jeremy123322/Self-playing-piano/1_Documentation/images/IMG_1840.jpg

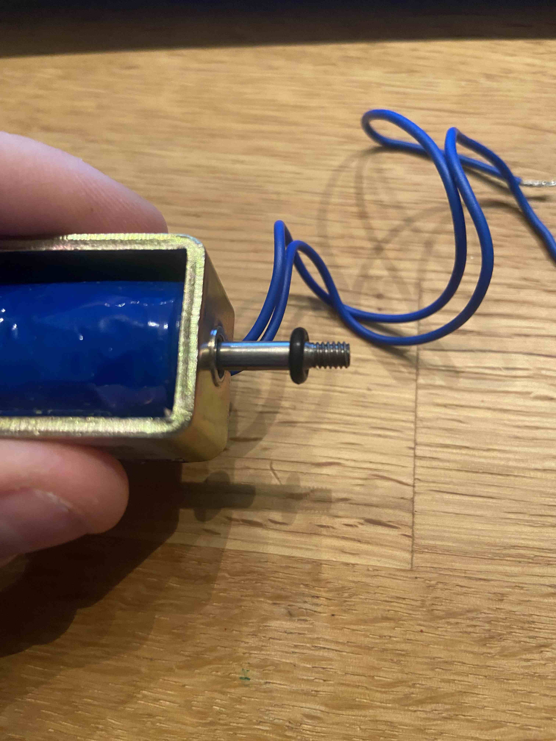
1_Documentation/images/IMG_1840.jpg
