jeremy123322/Self-playing-piano/4_Datasheets/PWM_Expander.png

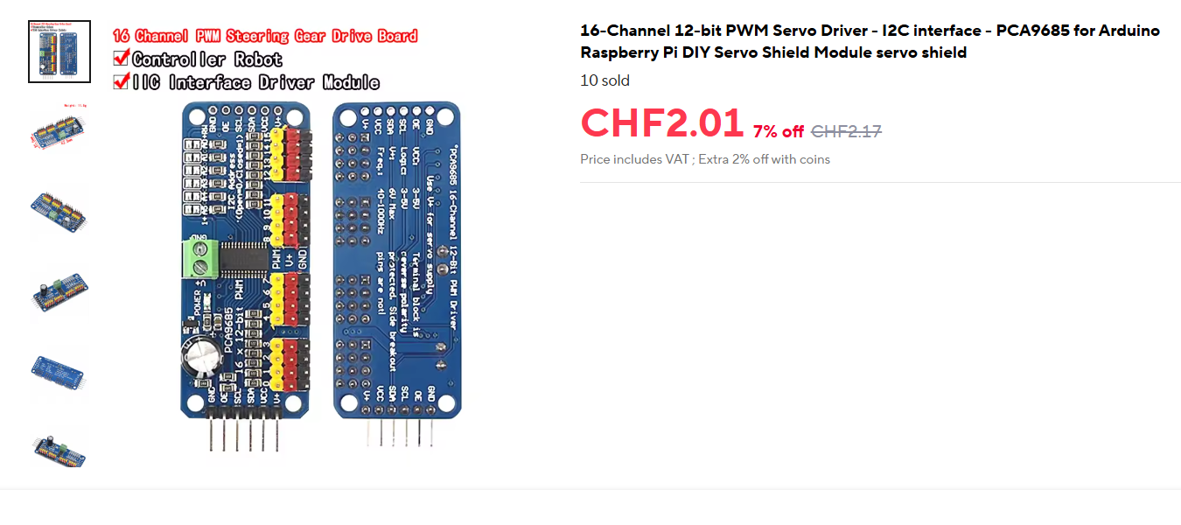
4_Datasheets/PWM_Expander.png
