jeremy123322/Self-playing-piano/5_Images/IMG_1639.jpg

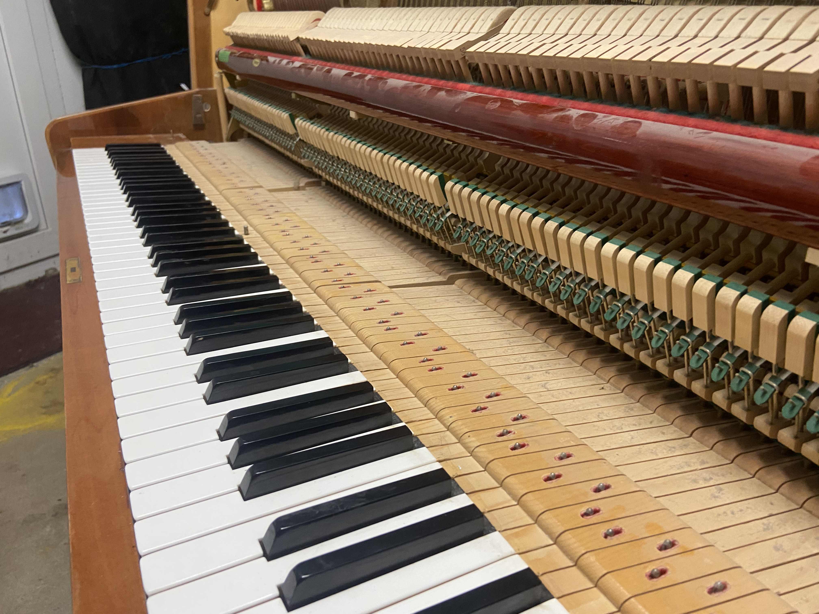
5_Images/IMG_1639.jpg
