jeremy123322/Self-playing-piano/5_Images/IMG_1664.jpg

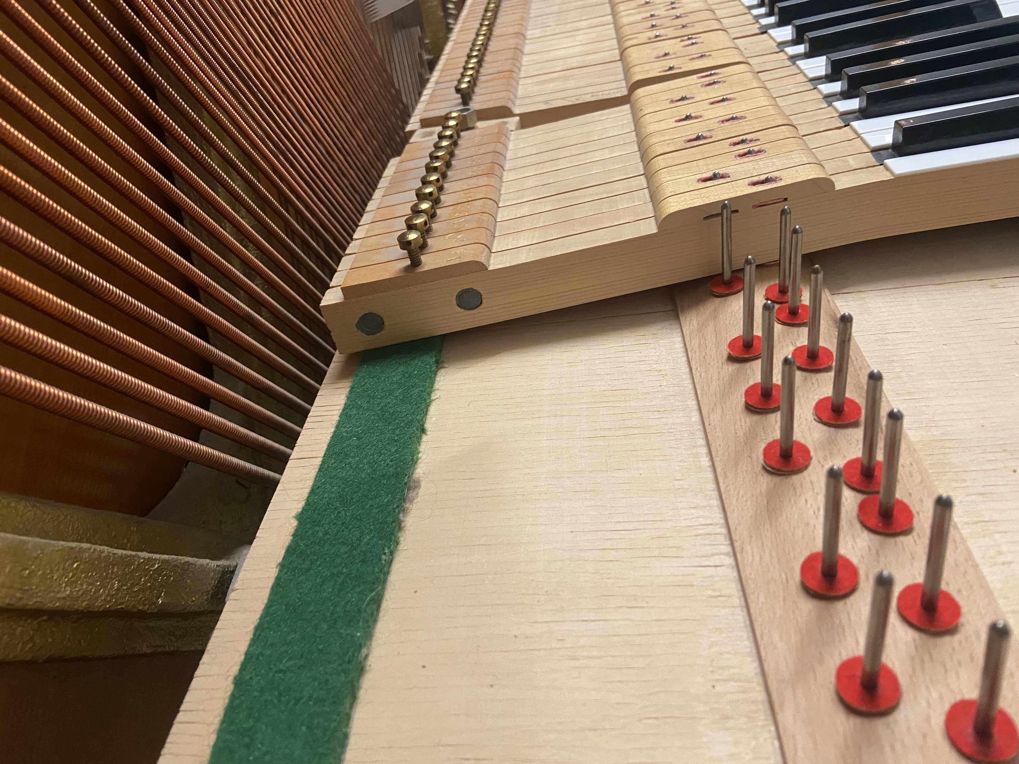
5_Images/IMG_1664.jpg
