jeremy123322/Self-playing-piano/5_Images/IMG_1673.jpg

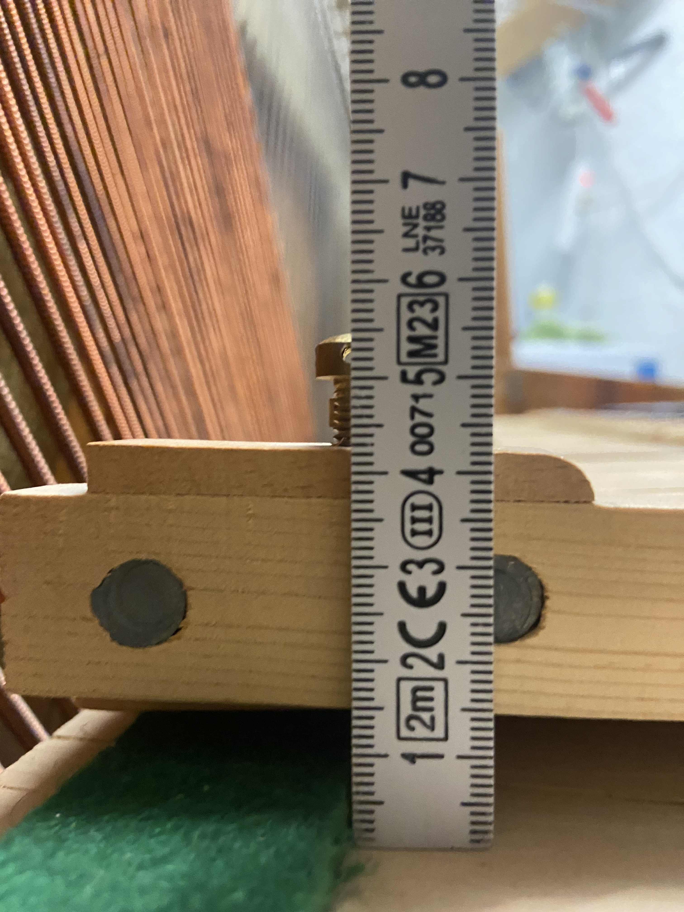
5_Images/IMG_1673.jpg
