jeremy123322/Self-playing-piano/2_Fabrication/BOM.xlsx

Liste de pièces self-playing-piano
Nom | Description | Fournisseur | Fabricant | Prix/Pce | Qté | Prix
Piano |  |  |  | 0 | 1 | 0
Tuning Hammer |  |  |  | CHF 28.60 | 1 | CHF 28.60
Cartes PWM expander | PCA9685-16 Channels |  |  | CHF 2.04 | 6 | CHF 12.24
Solenoids | JF-1039 B |  |  | CHF 5.00 | 1 | CHF 5.00
 |  |  |  |  |  | CHF 0.00
 |  |  |  |  |  | CHF 0.00
 |  |  |  |  |  | CHF 0.00
 |  |  |  |  |  | CHF 0.00
