jeremy123322/Self-playing-piano/2_Fabrication/A_Circuit/3D/pca9685_V2.step

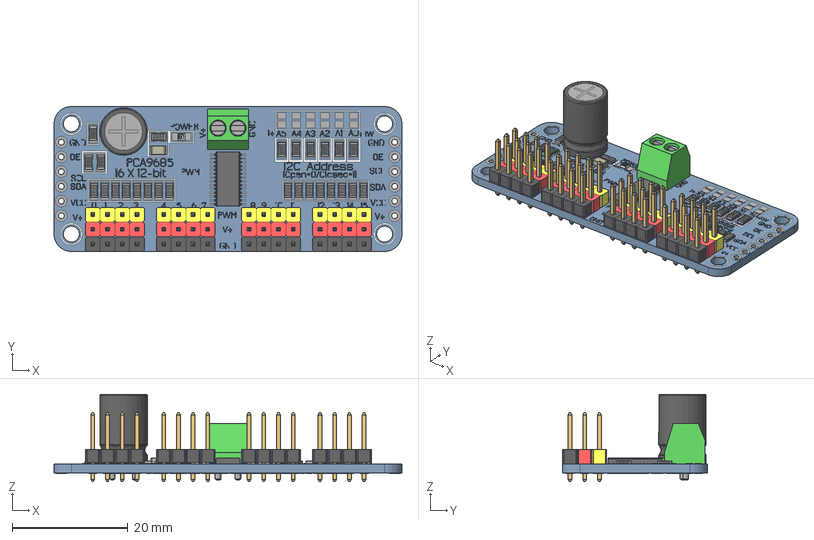
[picture p49: CAD file, 2026-11-05]
2_Fabrication/A_Circuit/3D/pca9685_V2.step
60.0 x 25.0 x 15.1 mm
SMD_DIODE_0.5_001
SMD_LED_rot_001
SMD_R_001 x 2
SMD_R_002 x 2
SMD_R_003 x 2
SMD_R_004 x 2
SMD_R_005 x 2
SMD_R_006 x 2
SMD_R_007 x 2
SMD_R_008 x 2
SMD_R_009 x 2
SMD_R_010 x 2
SMD_R_011 x 2
SMD_R_012 x 2
SMD_R_013 x 2
SMD_R_014 x 2
SMD_R_015 x 2
SMD_R_016 x 2
SMD_R_026 x 2
h-male-servo_001 x 2
h-male-servo_002 x 2
h-male-servo_003 x 2
h-male-servo_004 x 2
h-male-servo_005 x 2
h-male-servo_006 x 2
h-male-servo_007 x 2
h-male-servo_008 x 2
h-male-servo_009 x 2
h-male-servo_010 x 2
h-male-servo_011 x 2
h-male-servo_012 x 2
h-male-servo_013 x 2
h-male-servo_014 x 2
h-male-servo_015 x 2
h-male-servo_016 x 2
SMD_R_017 x 2
SMD_R_018 x 2
SMD_R_019 x 2
SMD_R_020 x 2
SMD_R_021 x 2
SMD_R_022 x 2
SMD_R_023 x 2
SMD_R_024 x 2
SMD_R_025 x 2
PCA9685-text-up_001
PCA9685-text-down_001
Platine
