jeremy123322/Self-playing-piano/2_Fabrication/B_Mecanique/Couplage/Couplage.stl

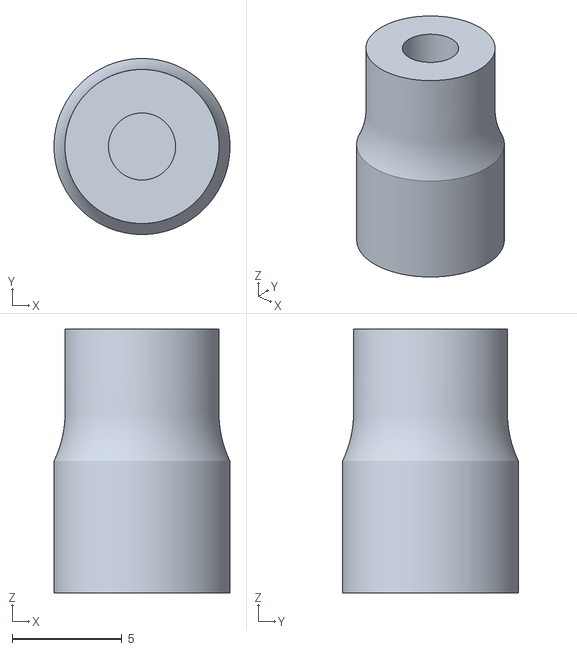
[picture p50: CAD file, 2026-11-05]
2_Fabrication/B_Mecanique/Couplage/Couplage.stl
8.00 x 8.00 x 12.0
