jeremy123322/Self-playing-piano/2_Fabrication/C_Impression3D/Solenoid_Guide.stl

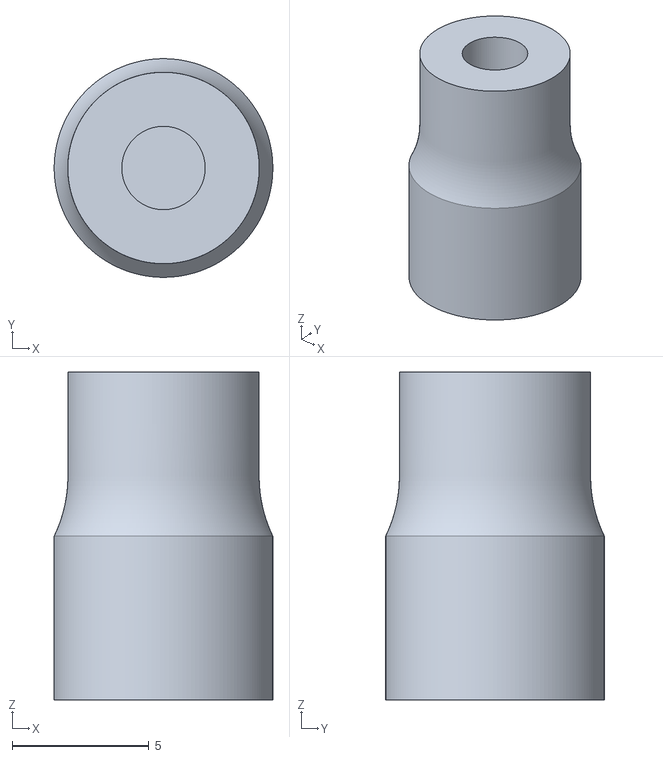
[picture p51: CAD file, 2026-11-05]
2_Fabrication/C_Impression3D/Solenoid_Guide.stl
8.00 x 8.00 x 12.0
