jeremy123322/Self-playing-piano/2_Fabrication/A_Circuit/3D/BLX-A Fuse.STEP

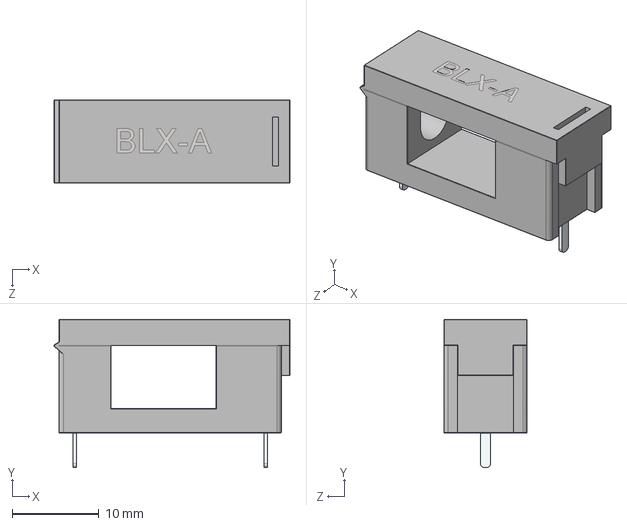
[picture p52: CAD file, 2026-11-05]
2_Fabrication/A_Circuit/3D/BLX-A Fuse.STEP
27.2 x 17.1 x 9.60 mm
