jeremy123322/Self-playing-piano/2_Fabrication/C_Impression3D/Guide.stl

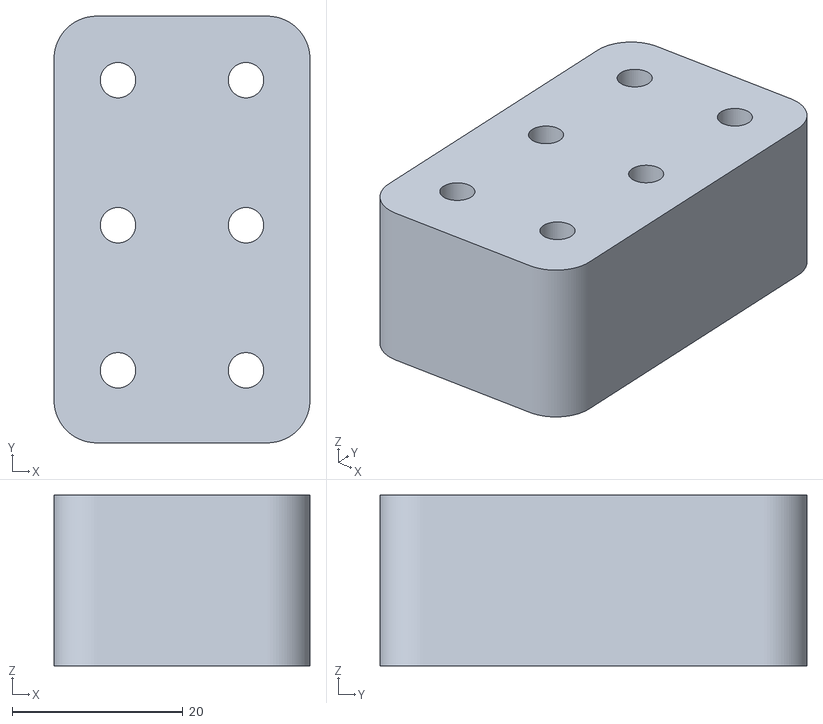
[picture p53: CAD file, 2026-11-05]
2_Fabrication/C_Impression3D/Guide.stl
30.0 x 50.0 x 20.0
