jeremy123322/Self-playing-piano/2_Fabrication/A_Circuit/3D/PCA9685.step

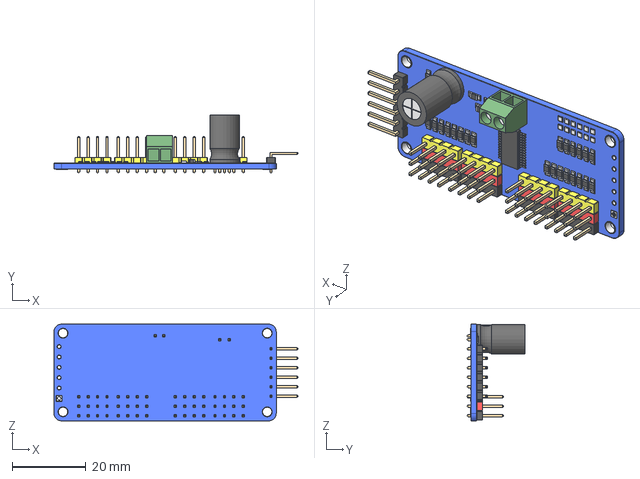
[picture p54: CAD file, 2026-11-05]
2_Fabrication/A_Circuit/3D/PCA9685.step
66.1 x 15.6 x 26.2 mm
