jeremy123322/Self-playing-piano/2_Fabrication/C_Impression3D/Fixation.stl

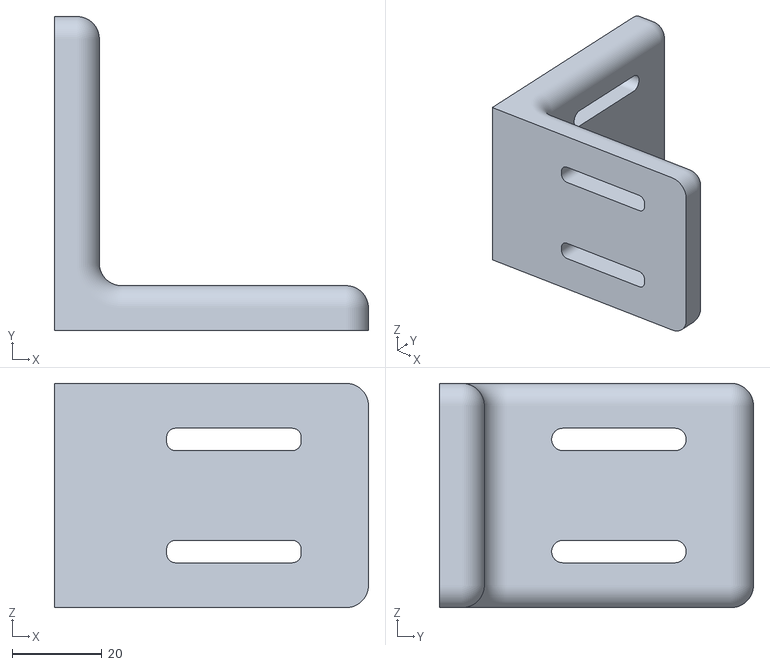
[picture p55: CAD file, 2026-11-05]
2_Fabrication/C_Impression3D/Fixation.stl
70.0 x 70.0 x 50.0
