jeremy123322/Self-playing-piano/2_Fabrication/C_Impression3D/Solenoid_Guide_Tall.stl

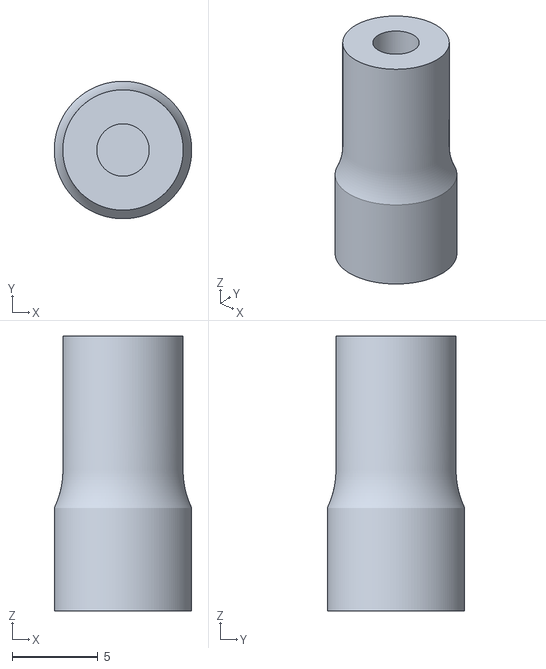
[picture p56: CAD file, 2026-11-05]
2_Fabrication/C_Impression3D/Solenoid_Guide_Tall.stl
8.00 x 8.00 x 16.0
