jeremy123322/Self-playing-piano/2_Fabrication/C_Impression3D/Alim_24V_Holder.stl

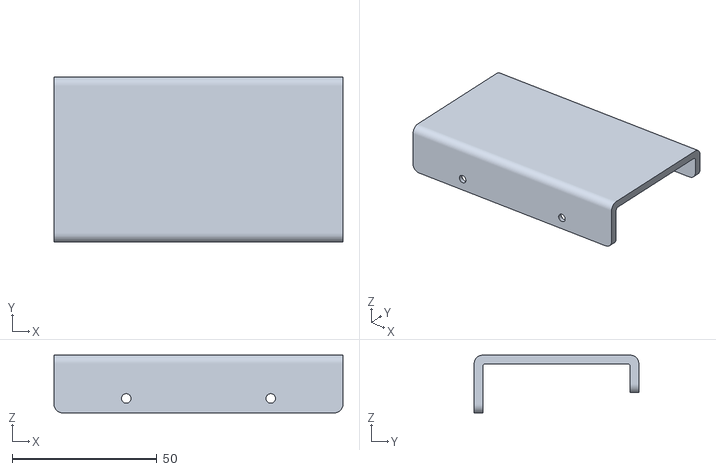
[picture p57: CAD file, 2026-11-05]
2_Fabrication/C_Impression3D/Alim_24V_Holder.stl
100.0 x 57.0 x 20.0
