jeremy123322/Self-playing-piano/2_Fabrication/C_Impression3D/Solenoid_Footprint.stl

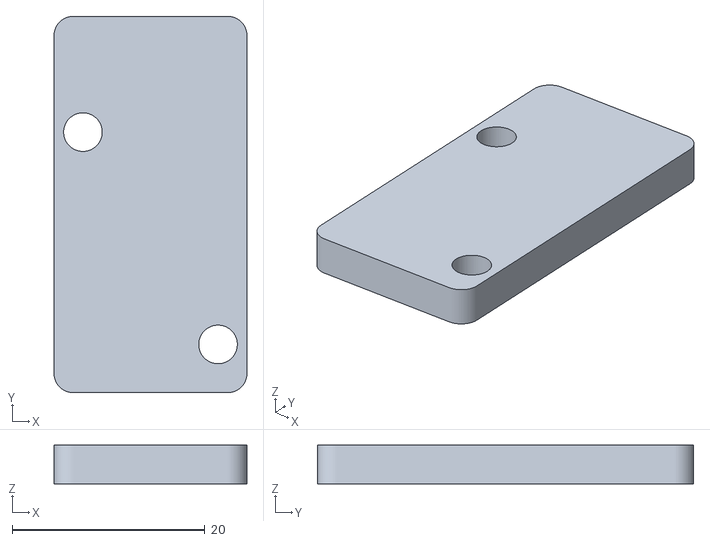
[picture p58: CAD file, 2026-11-05]
2_Fabrication/C_Impression3D/Solenoid_Footprint.stl
20.0 x 39.0 x 4.00
