jeremy123322/Self-playing-piano/2_Fabrication/C_Impression3D/Spacer.stl

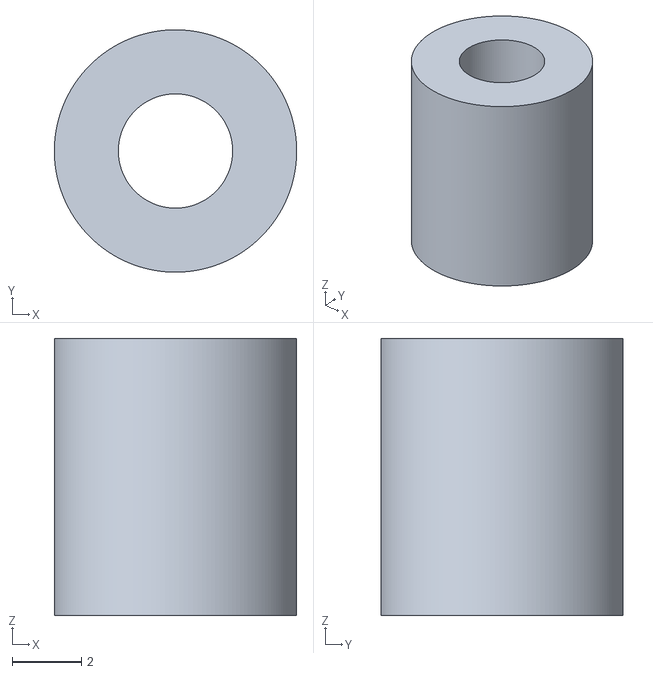
[picture p59: CAD file, 2026-11-05]
2_Fabrication/C_Impression3D/Spacer.stl
7.00 x 7.00 x 8.00
