jeremy123322/Self-playing-piano/(list of files, cad)

Other CAD files:
2_Fabrication/A_Circuit/3D/PCA9685.IGS
