jeremy123322/Self-playing-piano/7_Simulation/inductor.asc

D1: schottky; 1N5819
L1: ind; 10m
R1: res; 22
V1: voltage; PULSE(0 5 0 5u 5u 5m 10m 1000)
Named nets: 0, Vin, VL
.tran 0 2 1 0.00001
