jeremy123322/Self-playing-piano/7_Simulation/Mosfet.asc

R1: res
V1: voltage; PULSE(0 5 0 5u 5u 10ms 20ms 100)
V2: voltage; 24; Rser=0
Named nets: 0, 24V
.tran 0 1 0 0.0001
.include IRLZ44N.lib
