jeremy123322/Self-playing-piano/2_Fabrication/A_Circuit/SPP_motherboard/A_KiCad/SPP_motherboard.kicad_pcb

## KiCad design 2_Fabrication/A_Circuit/SPP_motherboard/A_KiCad/SPP_motherboard.kicad_pcb (2026-11-10)

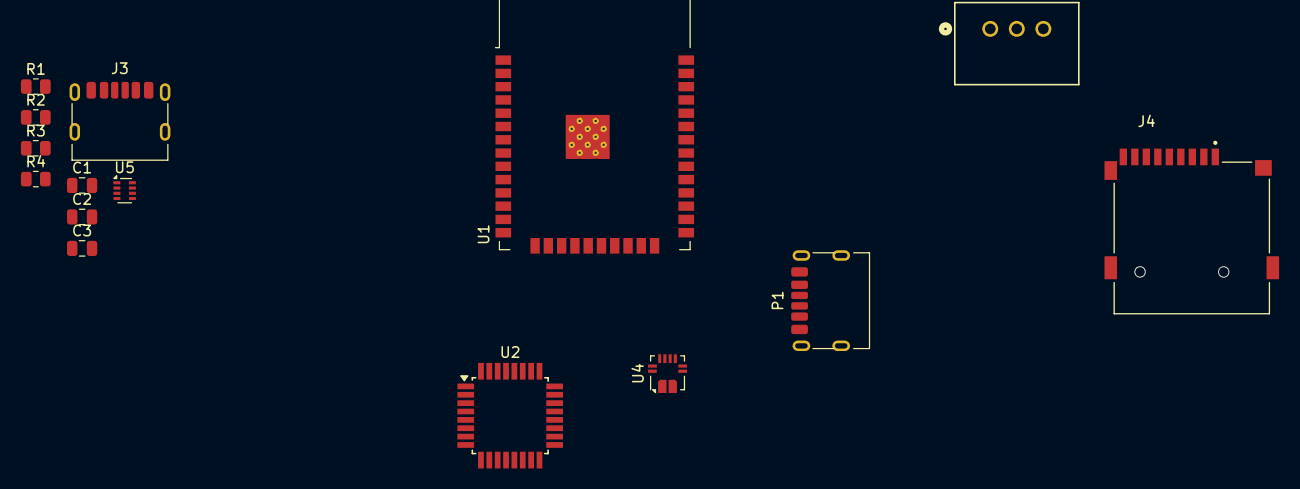
[picture p60: board SPP_motherboard.kicad_pcb from above]

Board: 2 copper layers, 15 parts (0 on the bottom side), 13 nets, no tracks yet.

Parts:
C1: 100nF; C_0805_2012Metric
C2: 10uF; C_0805_2012Metric
C3: 22uF; C_0805_2012Metric
J3: USB_C_Receptacle_USB2.0_14P; USB_C_Receptacle_HRO_TYPE-C-31-M-17
J4: Micro_SD_Card; CUI_MSD-1-A
P1: USB_C_Plug_USB2.0; USB_C_Receptacle_HRO_TYPE-C-31-M-17
R1, R2: 5.1k; R_0805_2012Metric
R3, R4: R; R_0805_2012Metric
U1: ESP32-WROOM-32
U2: ATmega328P-A; TQFP-32_7x7mm_P0.8mm
U2#2: RBT10W24S05; RBT10W24S05_XPP_XPR
U4: ACS711xEXLT-31AB; Allegro_QFN-12-10-1EP_3x3mm_P0.5mm
U5: TPS2116DRL; SOT-583-8

Connections:
+3V3: C1.1, C3.1, U4.10 (VCC)
+5V,DC/DC: U2#2.3 (Vout), U5.6 (VIN2)
+24V: U2#2.1 (Vin), U4.2 (IP-)
GND: C1.2, C2.2, C3.2, J3.A12 (GND), J3.B12 (GND), J3.S1 (SHIELD), R1.2, R2.2, R4.2, U2#2.2 (GND), U4.3 (GND), U5.1 (GND)
unnamed: J3.A5 (CC1), R2.1
unnamed: J3.B5 (CC2), R1.1
unnamed: P1.A12 (GND), P1.B12 (GND)
unnamed: P1.A9 (VBUS), P1.B9 (VBUS)
unnamed: U1.1 (GND), U1.15 (GND), U1.38 (GND), U1.39 (GND)
unnamed: U2.3 (GND), U2.5 (GND), U2.21 (GND)
unnamed: U2.4 (VCC), U2.6 (VCC)
unnamed: R3.2, R4.1, U5.4 (PR1)
VBUS: J3.A9 (VBUS), J3.B9 (VBUS), R3.1, U5.3 (VIN1), U5.5 (MODE)
