jeremy123322/Self-playing-piano/2_Fabrication/A_Circuit/SPP_solenoid_driver_board/A_KiCad/SPP_solenoid_driver_board.kicad_pcb

## KiCad design 2_Fabrication/A_Circuit/SPP_solenoid_driver_board/A_KiCad/SPP_solenoid_driver_board.kicad_pcb (2026-11-05)

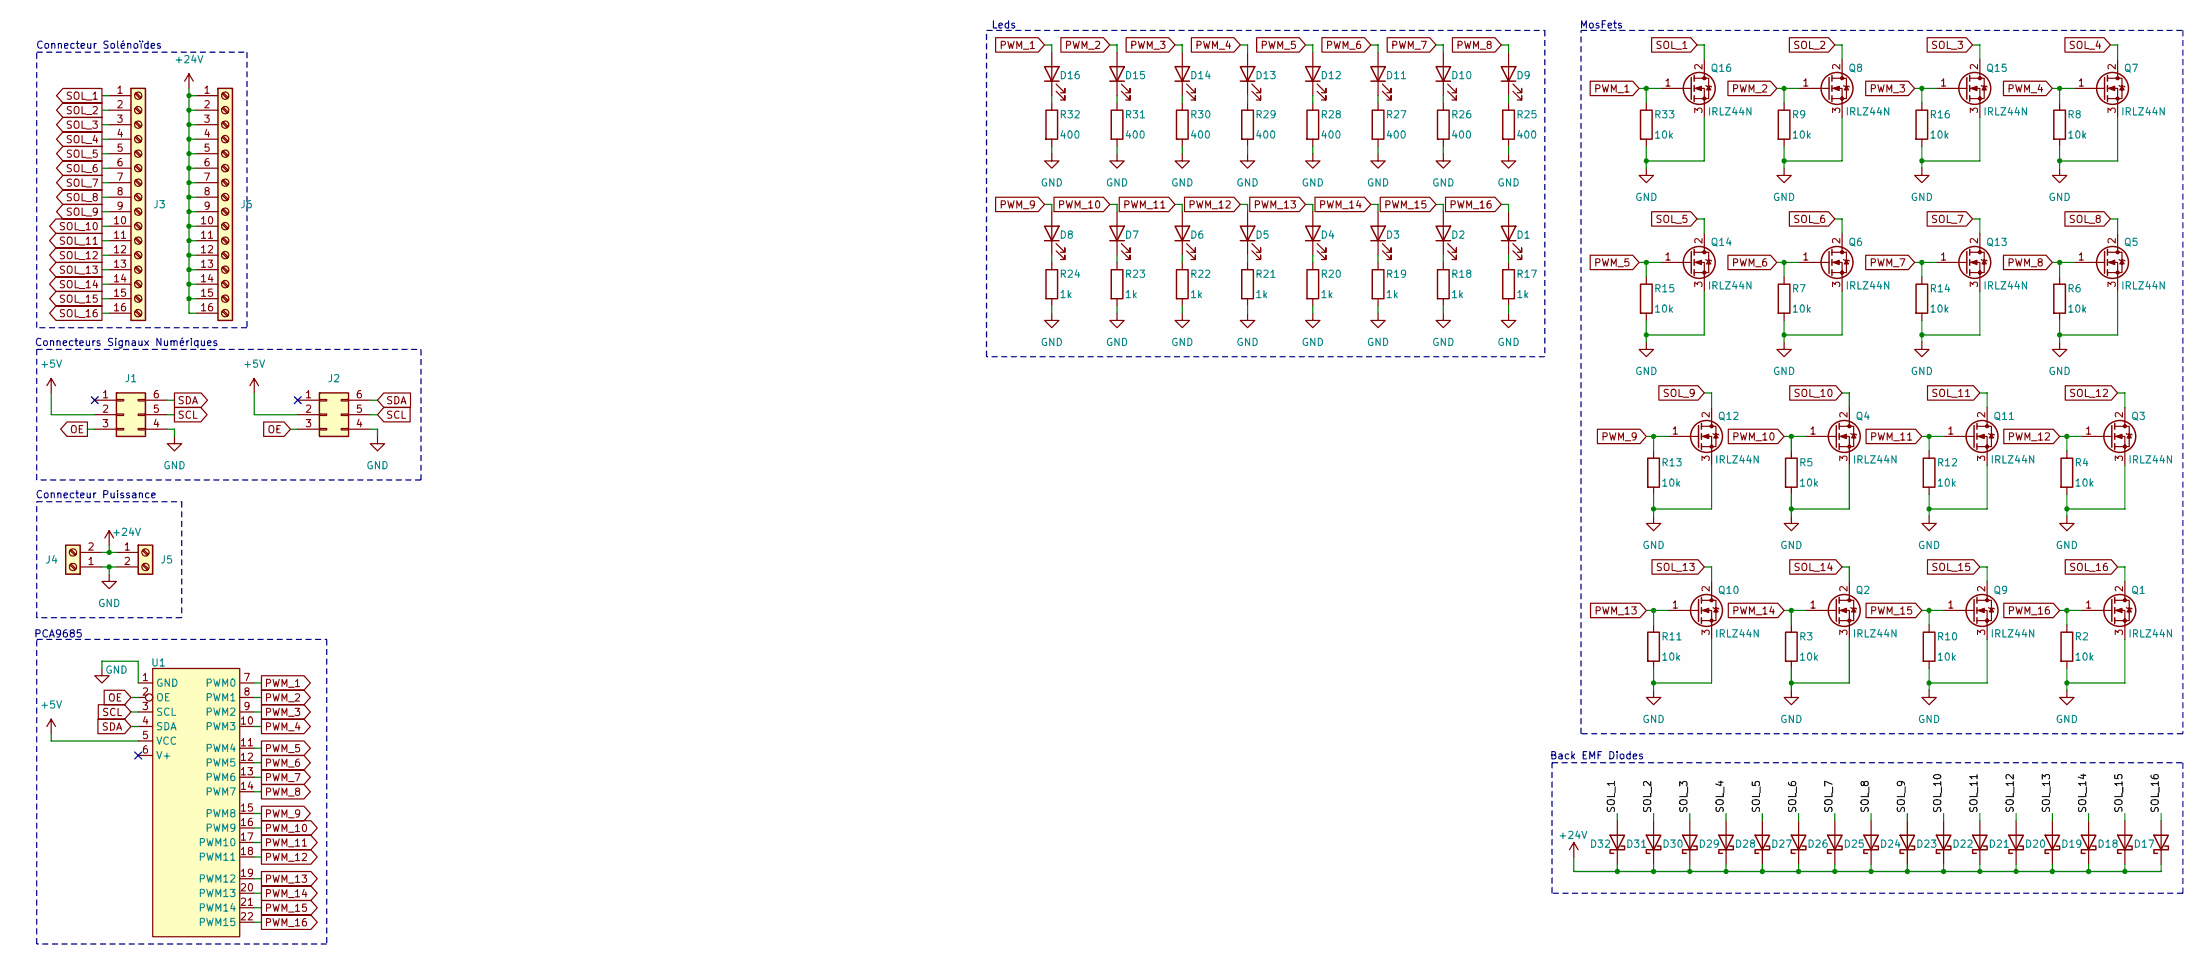
[picture p61: schematic SPP_solenoid_driver_board.kicad_sch]

Parts:
D1, D2, D3, D4, D5, D6, D7, D8, D9, D10, D11, D12, D13, D14, D15, D16: LED; LED_D5.0mm_Clear
D17, D18, D19, D20, D21, D22, D23, D24, D25, D26, D27, D28, D29, D30, D31, D32: 1N5819; D_DO-41_SOD81_P10.16mm_Horizontal
J1, J2: Conn_02x03_Counter_Clockwise; IDC-Header_2x03_P2.54mm_Vertical
J3, J6: Screw_Terminal_01x16; TerminalBlock_Phoenix_PT-1,5-16-5.0-H_1x16_P5.00mm_Horizont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
J4, J5: Screw_Terminal_01x02; TerminalBlock_Phoenix_MKDS-1,5-2_1x02_P5.00mm_Horizontal
Q1, Q2, Q3, Q4, Q5, Q6, Q7, Q8, Q9, Q10, Q11, Q12, Q13, Q14, Q15, Q16: IRLZ44N; TO-220-3_Vertical
R2, R3, R4, R5, R6, R7, R8, R9, R10, R11, R12, R13, R14, R15, R16, R33: 10k; R_1206_3216Metric
R17, R18, R19, R20, R21, R22, R23, R24: 1k; R_1206_3216Metric
R25, R26, R27, R28, R29, R30, R31, R32: 400; R_1206_3216Metric
U1: PCA9685_Devkit

Connections:
+5V: J1.2, J2.2, U1.5 (VCC)
+24V: D17.1 (K), D18.1 (K), D19.1 (K), D20.1 (K), D21.1 (K), D22.1 (K), D23.1 (K), D24.1 (K), D25.1 (K), D26.1 (K), D27.1 (K), D28.1 (K), D29.1 (K), D30.1 (K), D31.1 (K), D32.1 (K), J4.2, J5.1, J6.1, J6.2, J6.3, J6.4, J6.5, J6.6, J6.7, J6.8, J6.9, J6.10, J6.11, J6.12, J6.13, J6.14, J6.15, J6.16
GND: J1.4, J2.4, J4.1, J5.2, Q1.3 (S), Q2.3 (S), Q3.3 (S), Q4.3 (S), Q5.3 (S), Q6.3 (S), Q7.3 (S), Q8.3 (S), Q9.3 (S), Q10.3 (S), Q11.3 (S), Q12.3 (S), Q13.3 (S), Q14.3 (S), Q15.3 (S), Q16.3 (S), R2.2, R3.2, R4.2, R5.2, R6.2, R7.2, R8.2, R9.2, R10.2, R11.2, R12.2, R13.2, R14.2, R15.2, R16.2, R17.2, R18.2, R19.2, R20.2, R21.2, R22.2, R23.2, R24.2, R25.2, R26.2, R27.2, R28.2, R29.2, R30.2, R31.2, R32.2, R33.2, U1.1 (GND)
unnamed: D1.1 (K), R17.1
unnamed: D2.1 (K), R18.1
unnamed: D3.1 (K), R19.1
unnamed: D4.1 (K), R20.1
unnamed: D5.1 (K), R21.1
unnamed: D6.1 (K), R22.1
unnamed: D7.1 (K), R23.1
unnamed: D8.1 (K), R24.1
unnamed: D9.1 (K), R25.1
unnamed: D10.1 (K), R26.1
unnamed: D11.1 (K), R27.1
unnamed: D12.1 (K), R28.1
unnamed: D13.1 (K), R29.1
unnamed: D14.1 (K), R30.1
unnamed: D15.1 (K), R31.1
unnamed: D16.1 (K), R32.1
OE: J1.3, J2.3, U1.2 (OE)
PWM_1: D16.2 (A), Q16.1 (G), R33.1, U1.7 (PWM0)
PWM_2: D15.2 (A), Q8.1 (G), R9.1, U1.8 (PWM1)
PWM_3: D14.2 (A), Q15.1 (G), R16.1, U1.9 (PWM2)
PWM_4: D13.2 (A), Q7.1 (G), R8.1, U1.10 (PWM3)
PWM_5: D12.2 (A), Q14.1 (G), R15.1, U1.11 (PWM4)
PWM_6: D11.2 (A), Q6.1 (G), R7.1, U1.12 (PWM5)
PWM_7: D10.2 (A), Q13.1 (G), R14.1, U1.13 (PWM6)
PWM_8: D9.2 (A), Q5.1 (G), R6.1, U1.14 (PWM7)
PWM_9: D8.2 (A), Q12.1 (G), R13.1, U1.15 (PWM8)
PWM_10: D7.2 (A), Q4.1 (G), R5.1, U1.16 (PWM9)
PWM_11: D6.2 (A), Q11.1 (G), R12.1, U1.17 (PWM10)
PWM_12: D5.2 (A), Q3.1 (G), R4.1, U1.18 (PWM11)
PWM_13: D4.2 (A), Q10.1 (G), R11.1, U1.19 (PWM12)
PWM_14: D3.2 (A), Q2.1 (G), R3.1, U1.20 (PWM13)
PWM_15: D2.2 (A), Q9.1 (G), R10.1, U1.21 (PWM14)
PWM_16: D1.2 (A), Q1.1 (G), R2.1, U1.22 (PWM15)
SCL: J1.5, J2.5, U1.3 (SCL)
SDA: J1.6, J2.6, U1.4 (SDA)
SOL_1: D32.2 (A), J3.1, Q16.2 (D)
SOL_2: D31.2 (A), J3.2, Q8.2 (D)
SOL_3: D30.2 (A), J3.3, Q15.2 (D)
SOL_4: D29.2 (A), J3.4, Q7.2 (D)
SOL_5: D28.2 (A), J3.5, Q14.2 (D)
SOL_6: D27.2 (A), J3.6, Q6.2 (D)
SOL_7: D26.2 (A), J3.7, Q13.2 (D)
SOL_8: D25.2 (A), J3.8, Q5.2 (D)
SOL_9: D24.2 (A), J3.9, Q12.2 (D)
SOL_10: D23.2 (A), J3.10, Q4.2 (D)
SOL_11: D22.2 (A), J3.11, Q11.2 (D)
SOL_12: D21.2 (A), J3.12, Q3.2 (D)
SOL_13: D20.2 (A), J3.13, Q10.2 (D)
SOL_14: D19.2 (A), J3.14, Q2.2 (D)
SOL_15: D18.2 (A), J3.15, Q9.2 (D)
SOL_16: D17.2 (A), J3.16, Q1.2 (D)

Notes on the sheet:
Back EMF Diodes
MosFets
Leds
PCA9685
Connecteurs Signaux Numériques
Connecteur Puissance
Connecteur Solénoïdes

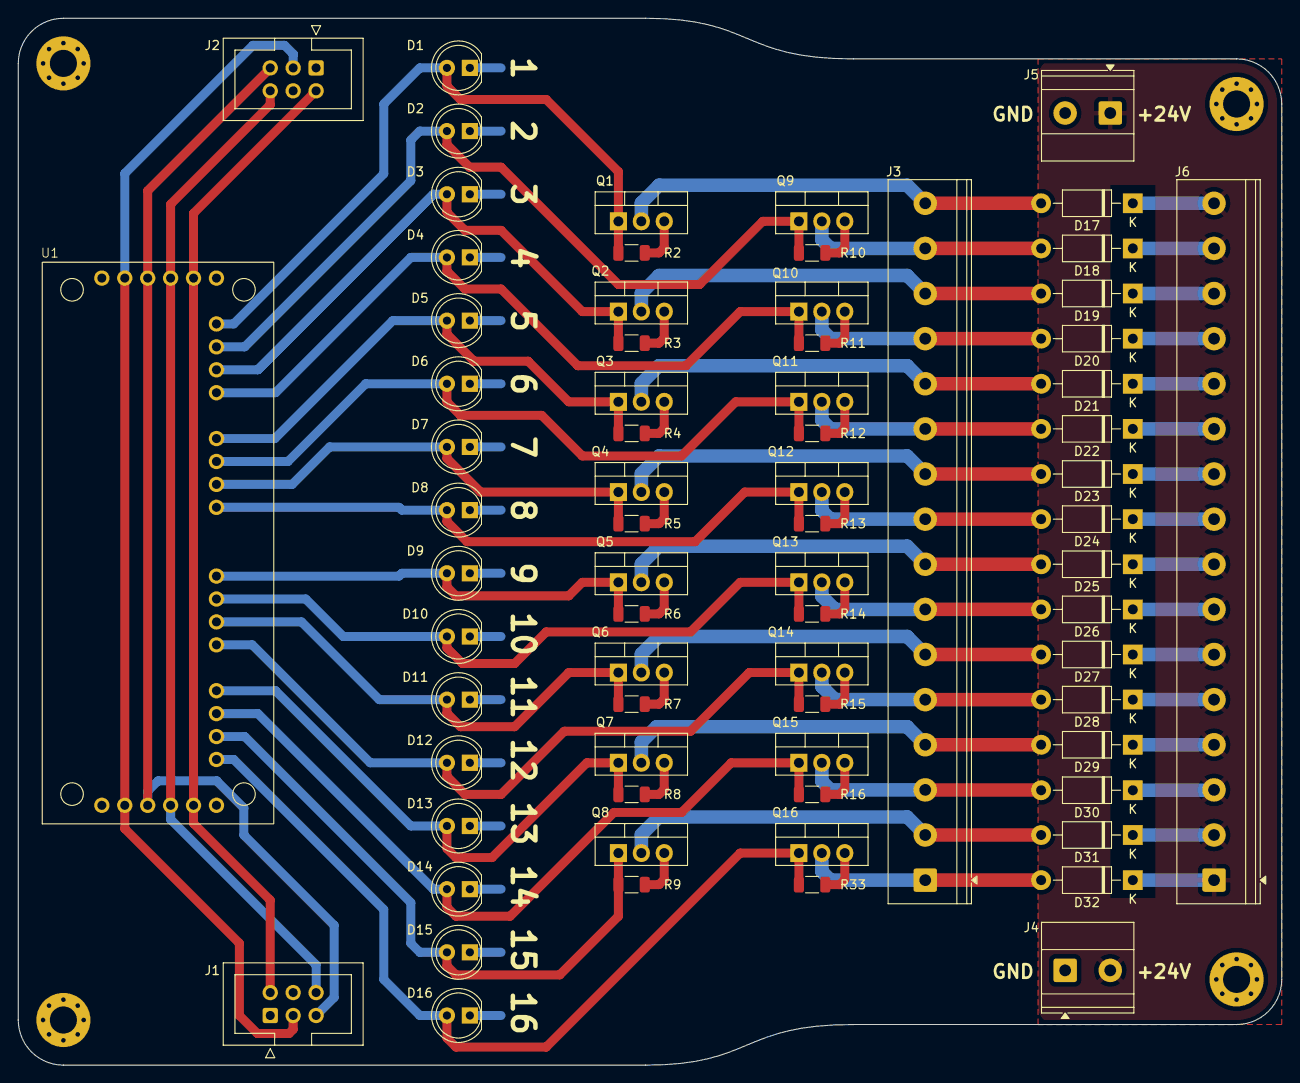
[picture p62: board SPP_solenoid_driver_board.kicad_pcb from above]

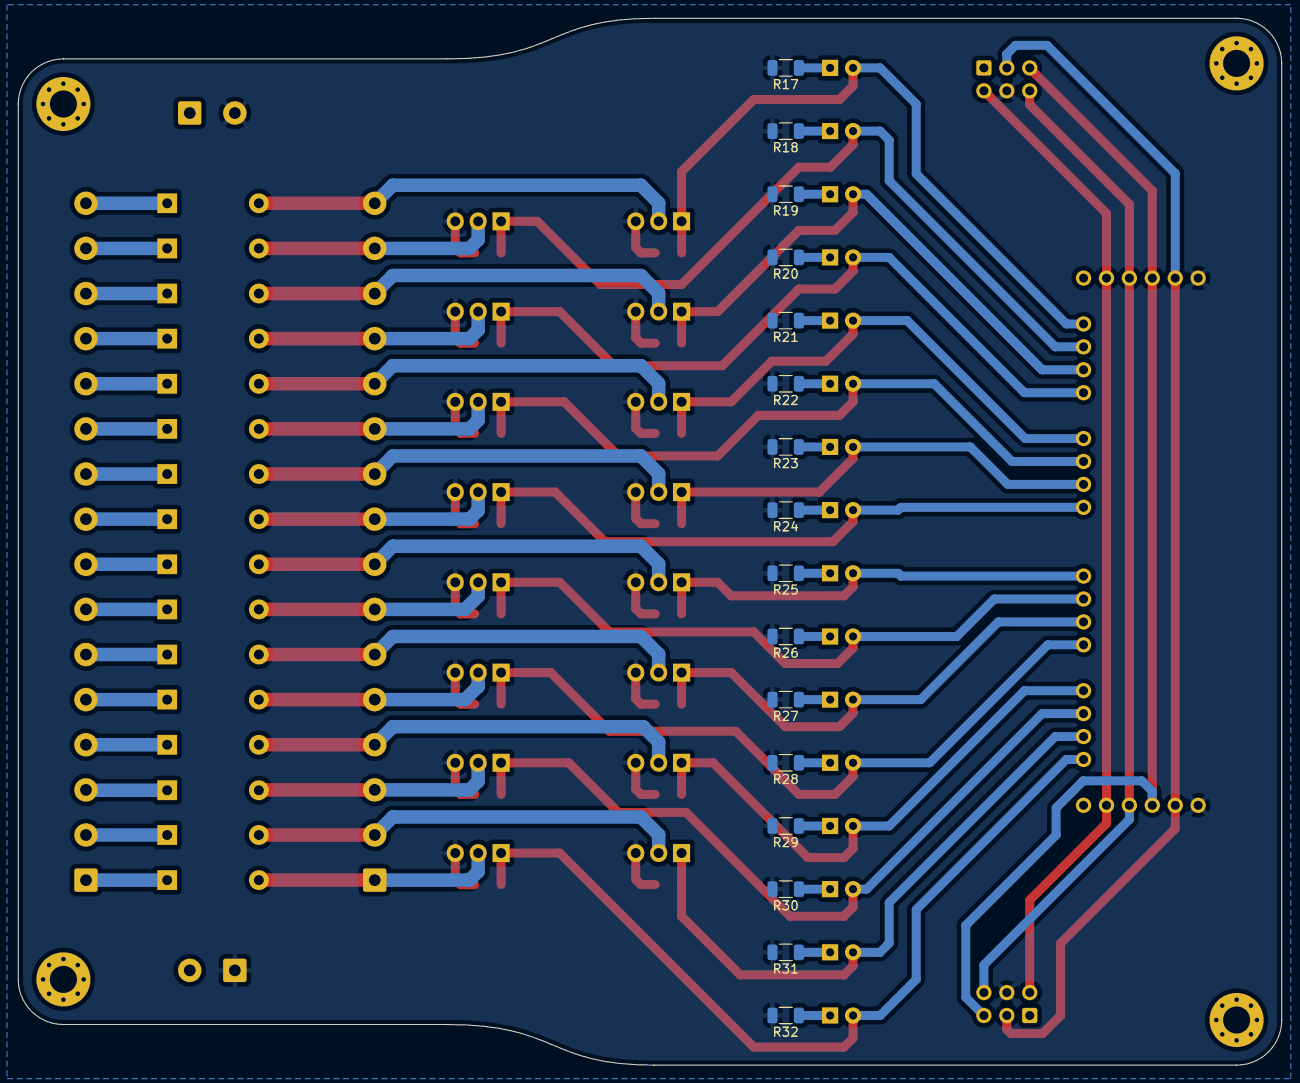
[picture p63: board SPP_solenoid_driver_board.kicad_pcb from below]

Board: 2 copper layers, 140.0 x 116.0 mm, 87 parts (16 on the bottom side), 54 nets.
