jeremy123322/Self-playing-piano/(commit log)

2026-11-05 Project merge from onedrive, new firmware uploaded (IA generated), V1
    [Alim_24V_Holder.stl, BLX-A Fuse.STEP, BOM.xlsx, Couplage.stl, Fixation.stl, Guide.stl, PCA9685.IGS, PCA9685.step]
2026-11-05 Added new KiCad project for motherboard.
    [SPP_motherboard.kicad_pcb, SPP_motherboard.kicad_sch, SPP_solenoid_driver_board.kicad_pcb, SPP_solenoid_driver_board.kicad_sch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]
2026-11-10 Files rearangement, motherboard design
    [BLX-A Fuse.STEP, BOM.xlsx, PCA9685.IGS, PCA9685.step, SPP_motherboard.kicad_pcb, SPP_motherboard.kicad_sch, SPP_solenoid_driver_board.kicad_pcb, SPP_solenoid_driver_board.kicad_sch]
2026-11-10 Added missing files
    [BLX-A Fuse.STEP, PCA9685.IGS, PCA9685.step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]
2026-11-10 Motherboard progress, power supply, SD card reader
    [SPP_motherboard.kicad_pcb, SPP_motherboard.kicad_sch]
2026-11-12 Motherboard progress, ESP-32 start, current sensor, power MUX
    [ESP32.kicad_sch, SPP_motherboard.kicad_sch]
